stawel/magiczna-palka/mgr/praca/2d.png

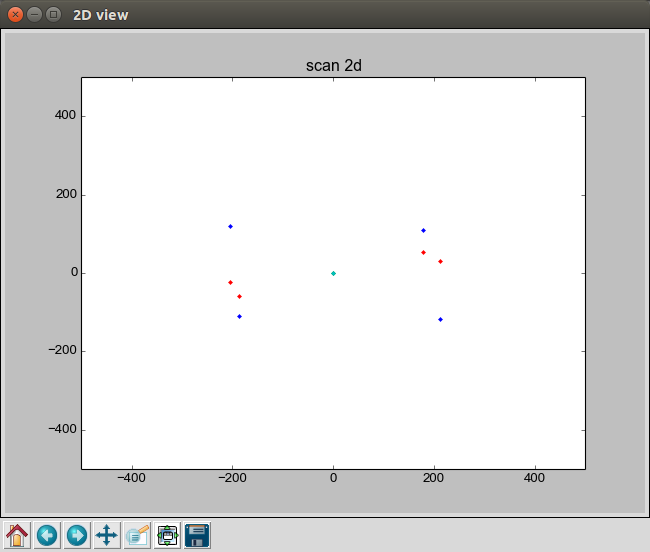
mgr/praca/2d.png
