stawel/magiczna-palka/mgr/praca/3d.png

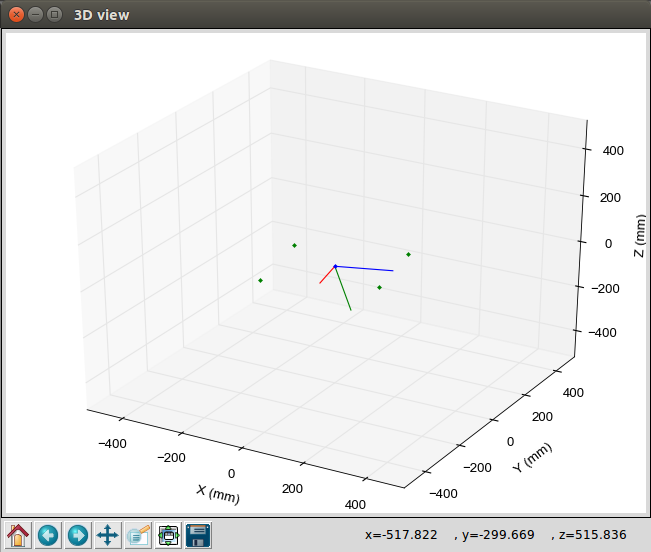
mgr/praca/3d.png
