stawel/magiczna-palka/mgr/praca/odbiornik_szkic.png

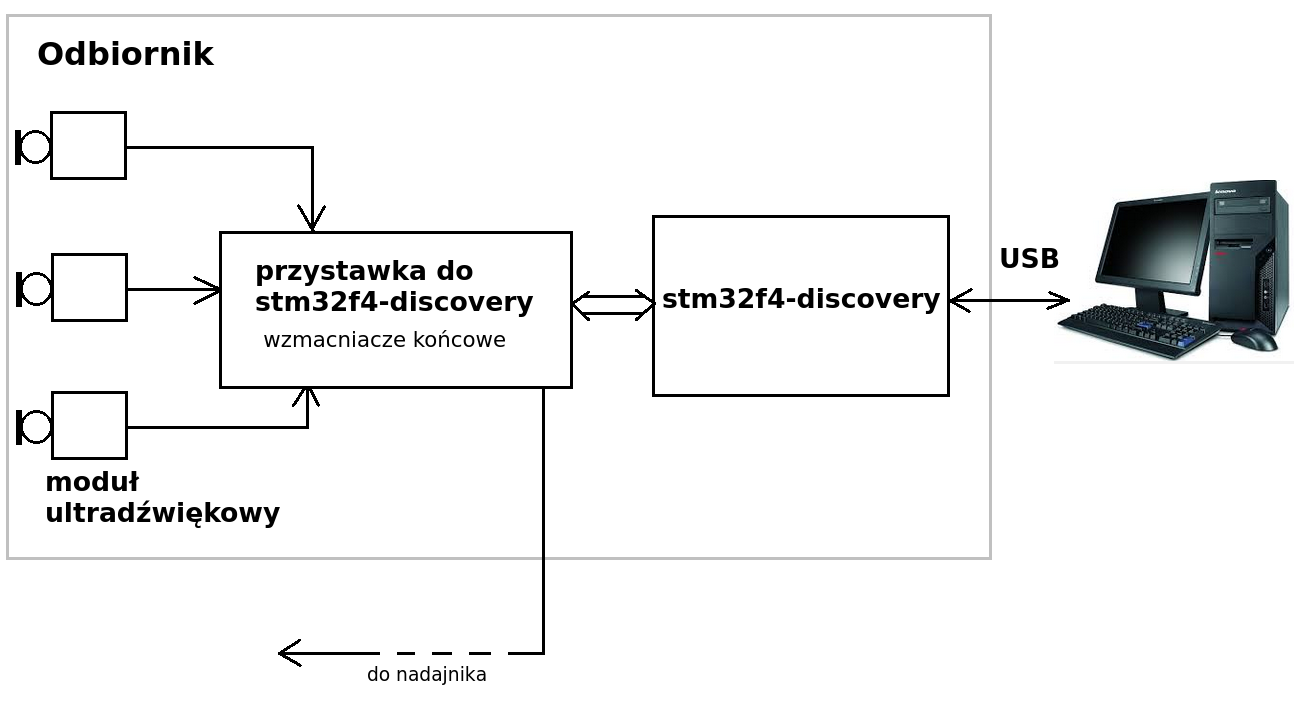
mgr/praca/odbiornik_szkic.png
