stawel/magiczna-palka/mgr/praca/polozenie.png

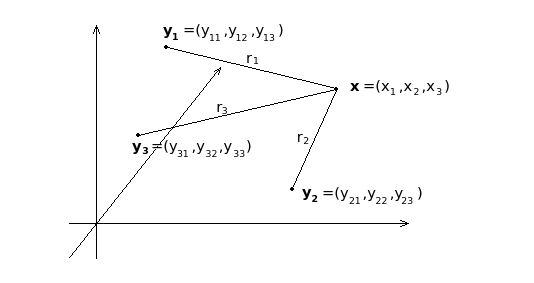
mgr/praca/polozenie.png
