stawel/magiczna-palka/mgr/praca/pomiar_odleglosci.png

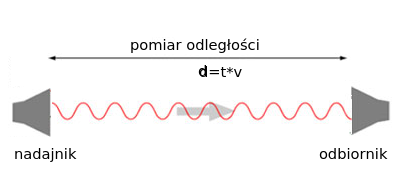
mgr/praca/pomiar_odleglosci.png
