stawel/magiczna-palka/mgr/praca/power.png

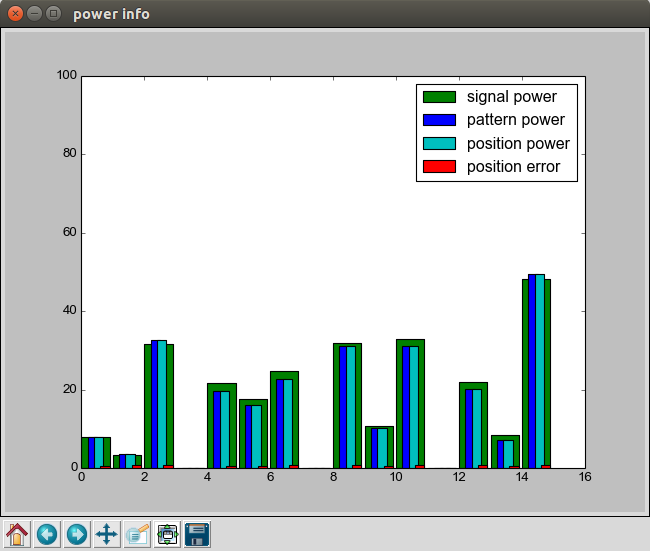
mgr/praca/power.png
