stawel/magiczna-palka/mgr/cad/nadajnik_H2.dxf

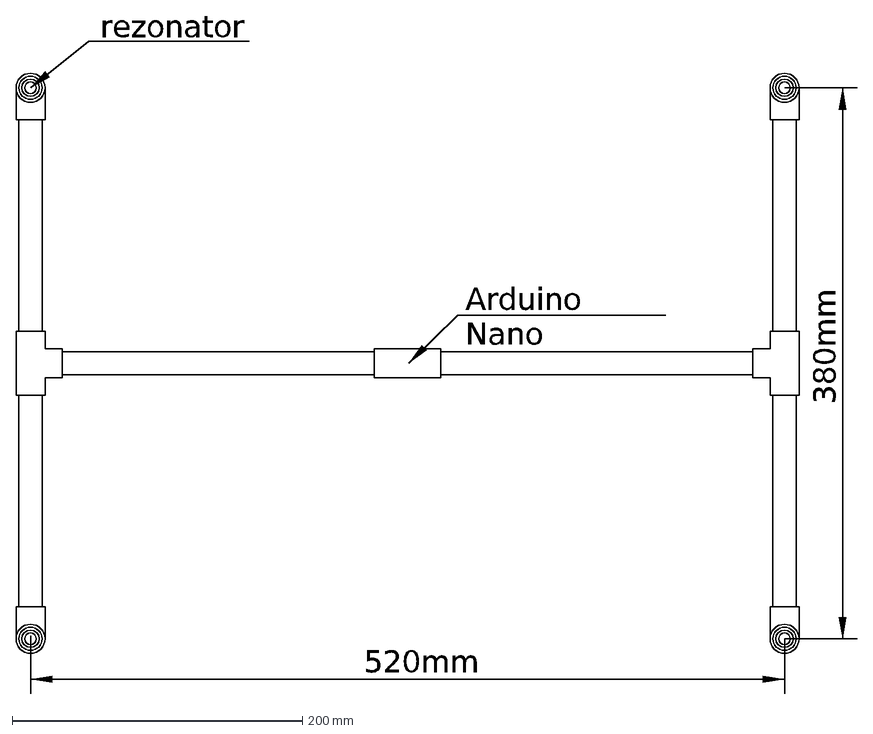
[picture p8: CAD file, 2015-10-09]
mgr/cad/nadajnik_H2.dxf
rezonator
Arduino Nano
520mm
380mm
