stawel/magiczna-palka/mgr/cad/trojkat.dxf

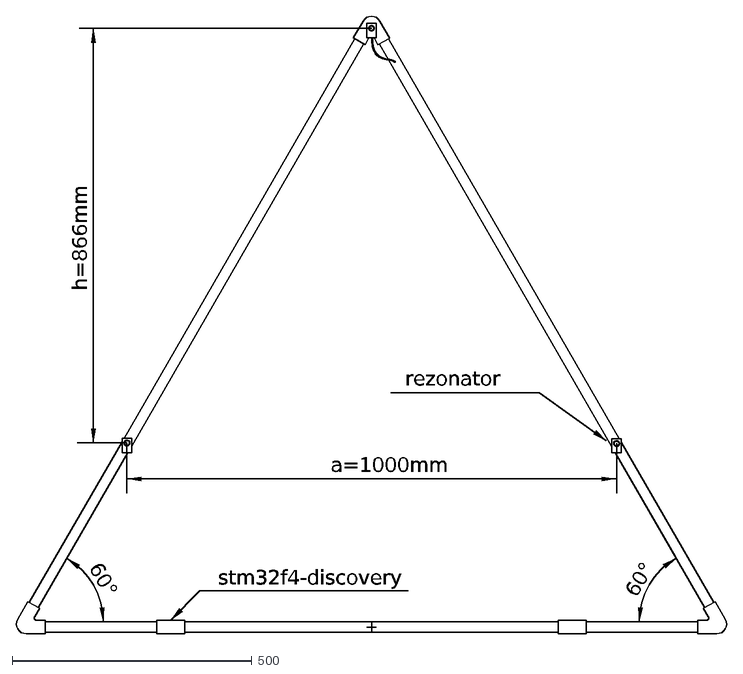
[picture p9: CAD file, 2015-10-09]
mgr/cad/trojkat.dxf
60°
stm32f4-discovery
h=866mm
a=1000mm
rezonator
