stawel/magiczna-palka/mgr/cad/nadajnik_H.dxf

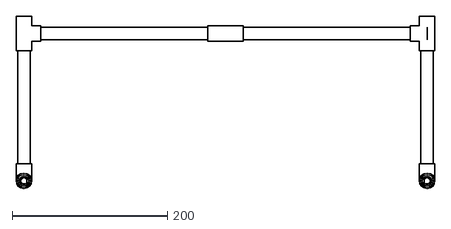
[picture p10: CAD file, 2014-08-22]
mgr/cad/nadajnik_H.dxf
540.0 x 222.0
