stawel/magiczna-palka/mgr/praca/kalibracja.tex

\chapter{Kalibracja}\label{r:kalibracja}

Do poprawnego działania prototupu niezbędne są wzorce
