stawel/magiczna-palka/mgr/praca/TODO.png

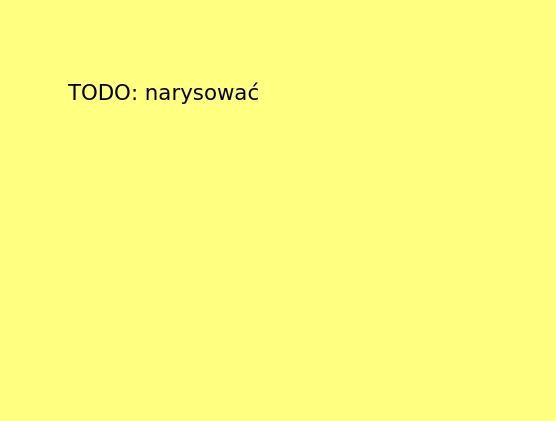
mgr/praca/TODO.png
