stawel/magiczna-palka/mgr/praca/transmitter.pdf

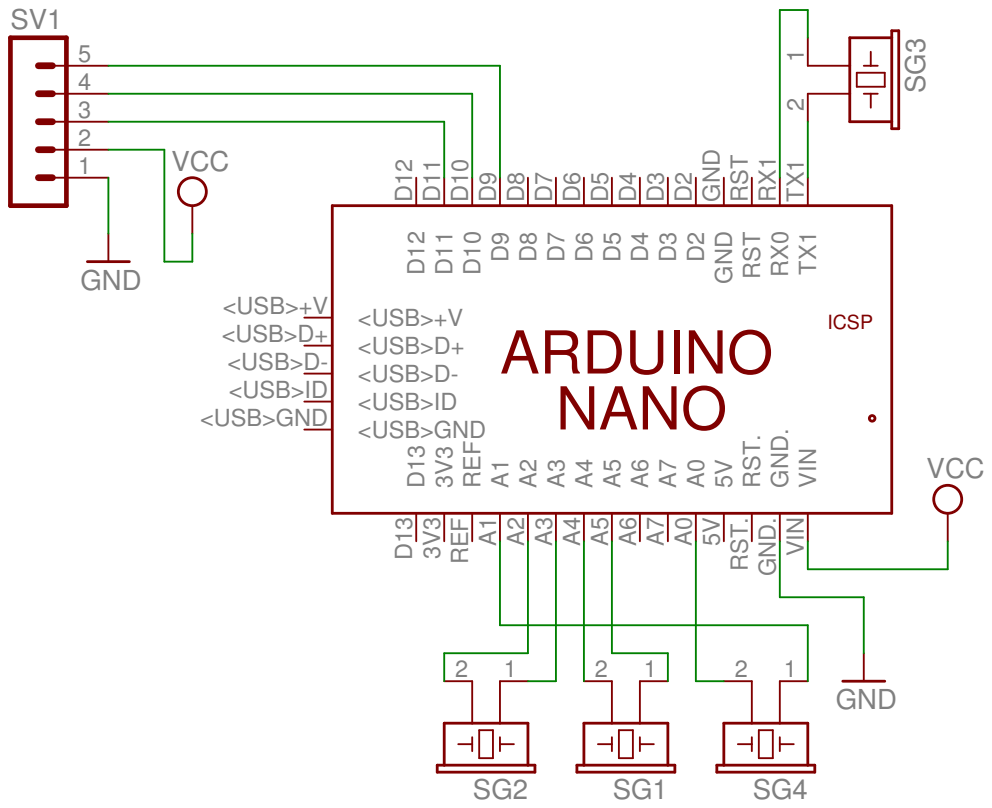
[picture p12: page 1]

5V RST. RST. GND. GND.
