stawel/magiczna-palka/mgr/praca/kalibracja_12x.pdf

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

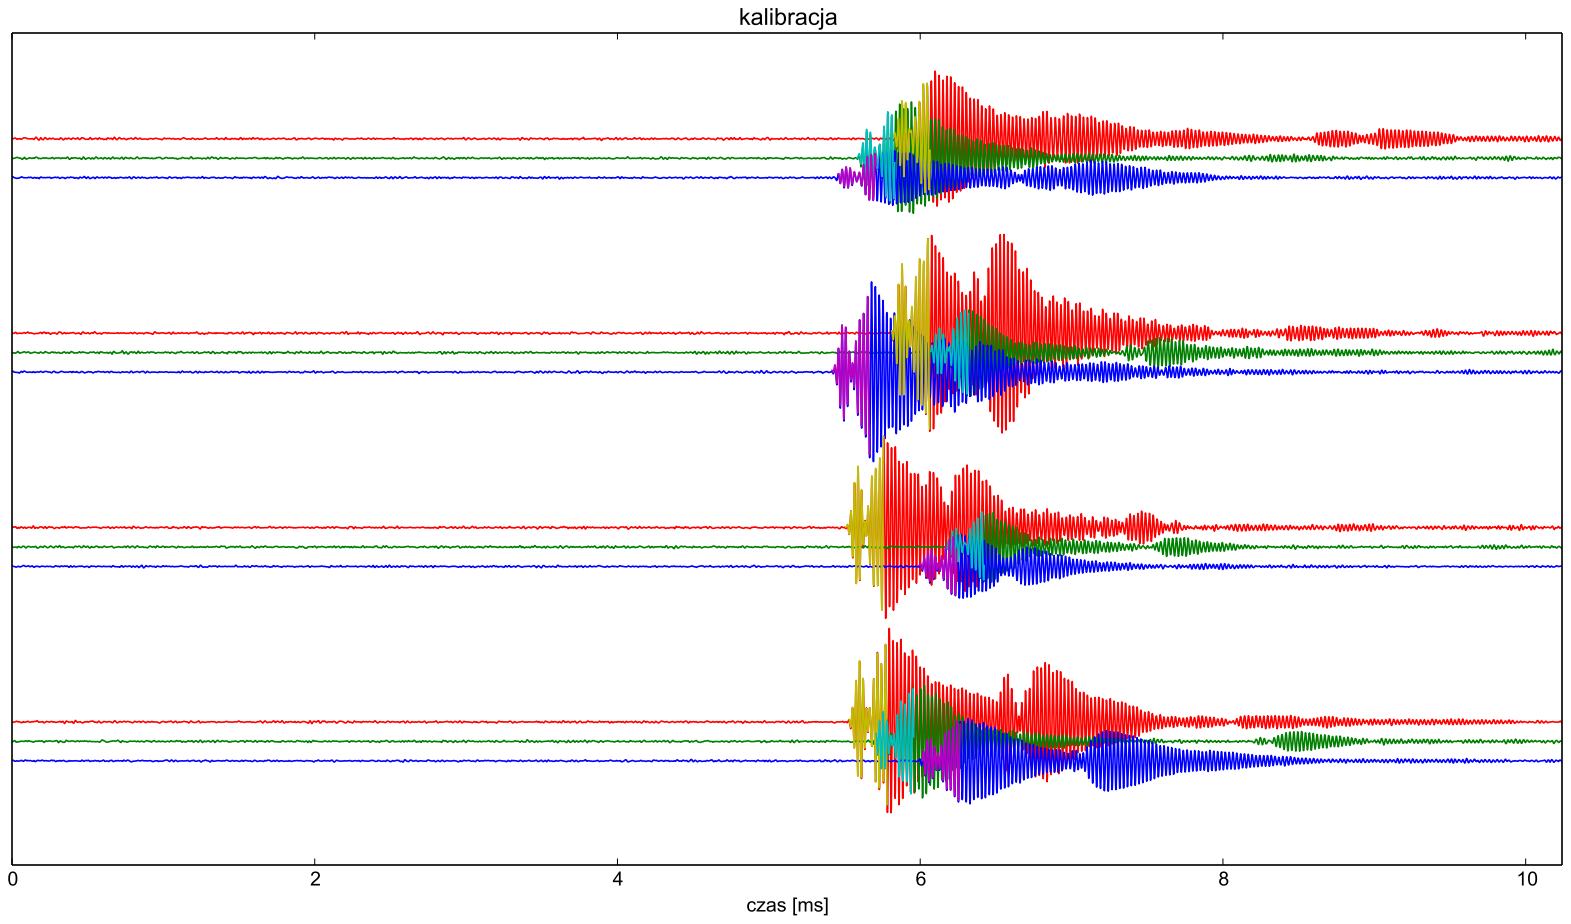
[picture p13: page 1]
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
