stawel/magiczna-palka/mgr/praca/nadajnik_H.pdf

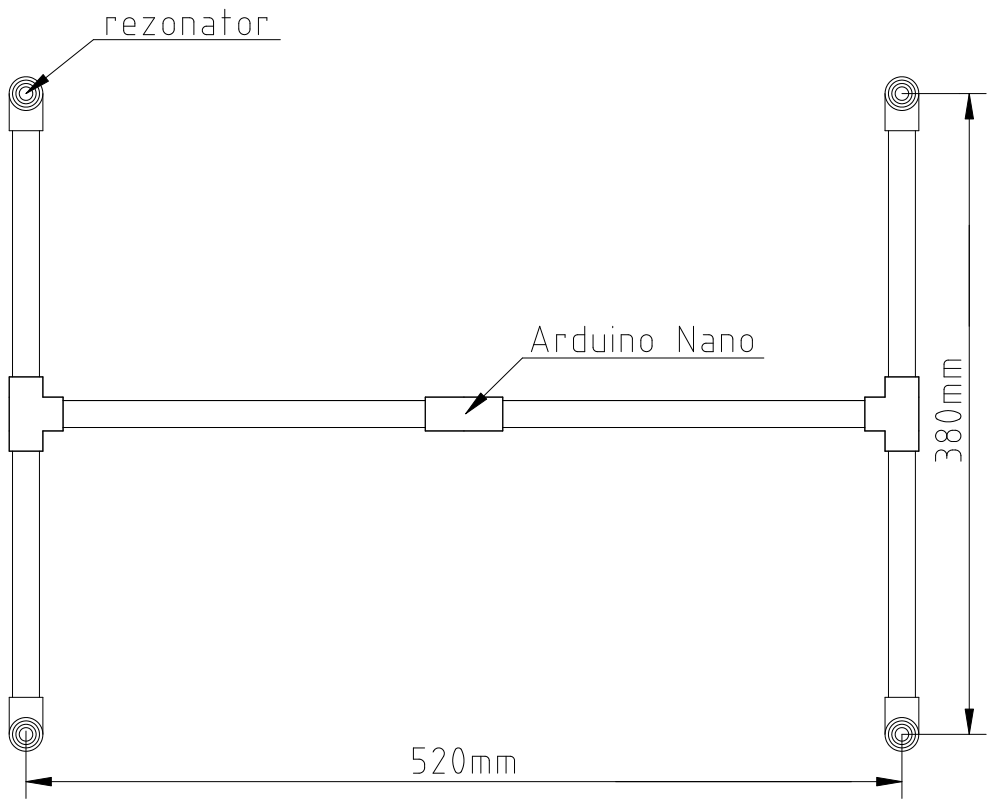
[picture p18: page 1]
