stawel/magiczna-palka/mgr/praca/trojkat.pdf

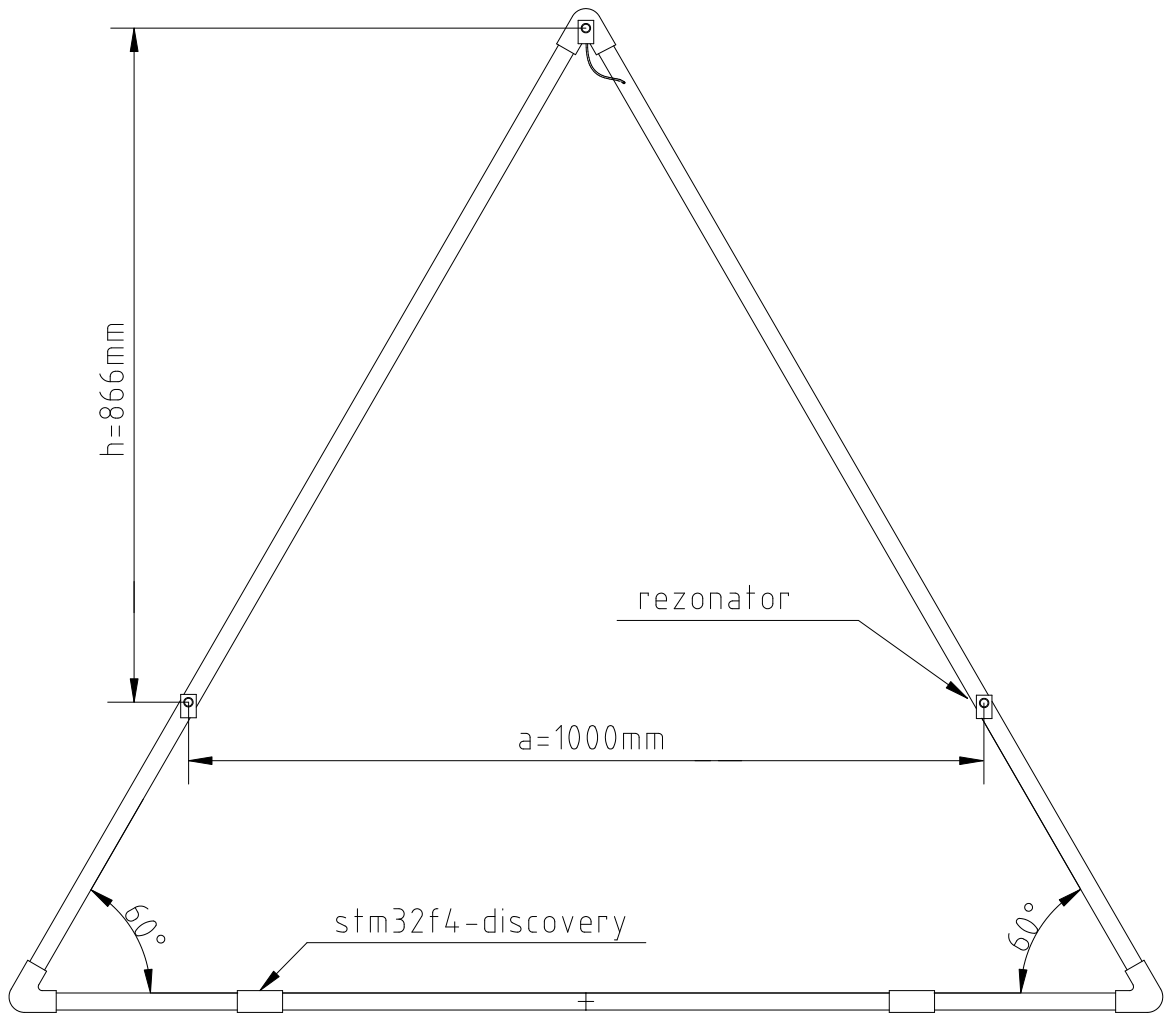
[picture p19: page 1]
