stawel/magiczna-palka/mgr/praca/mainboard2.pdf

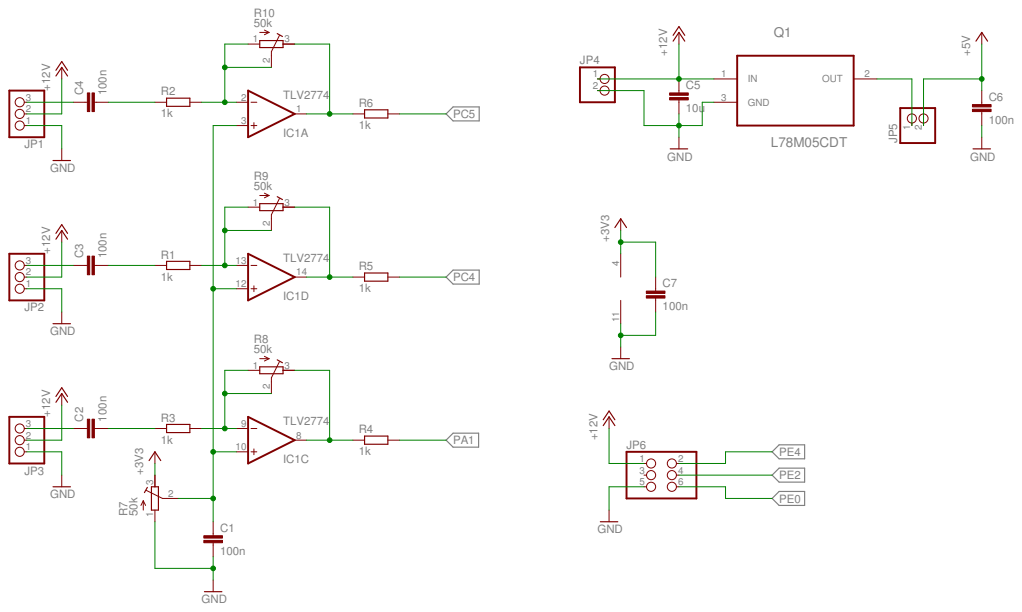
[picture p21: page 1]
