stawel/magiczna-palka/mgr/praca/receiver.pdf

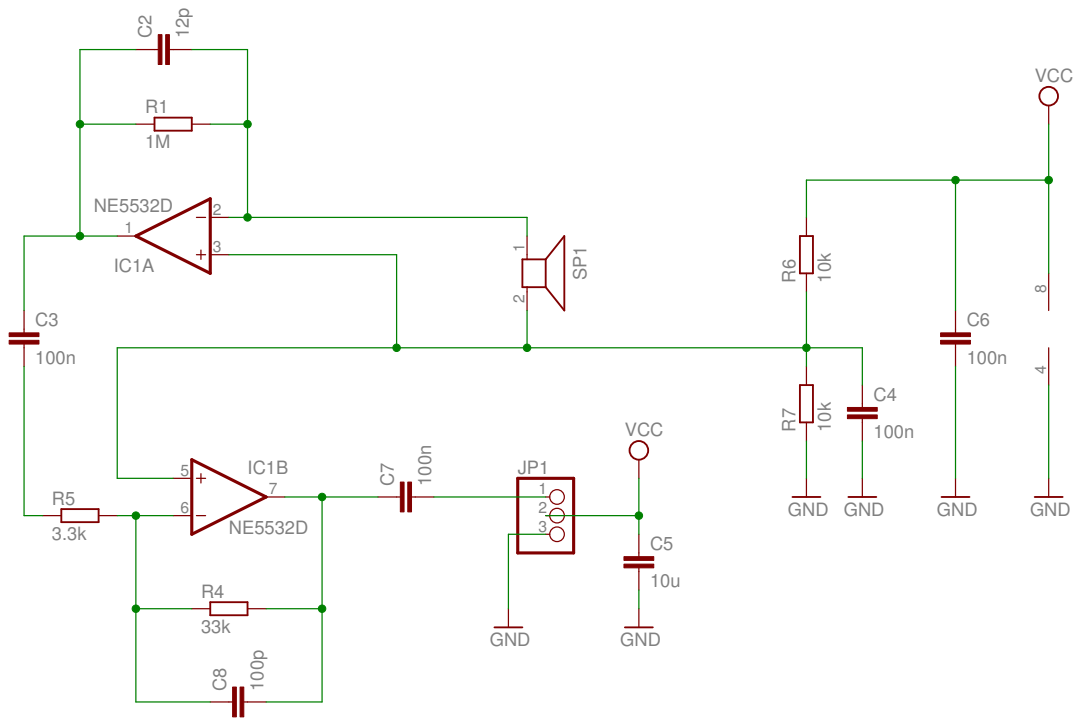
[picture p22: page 1]
