stawel/magiczna-palka/pos-receiver-sch/receiver/receiver.pdf

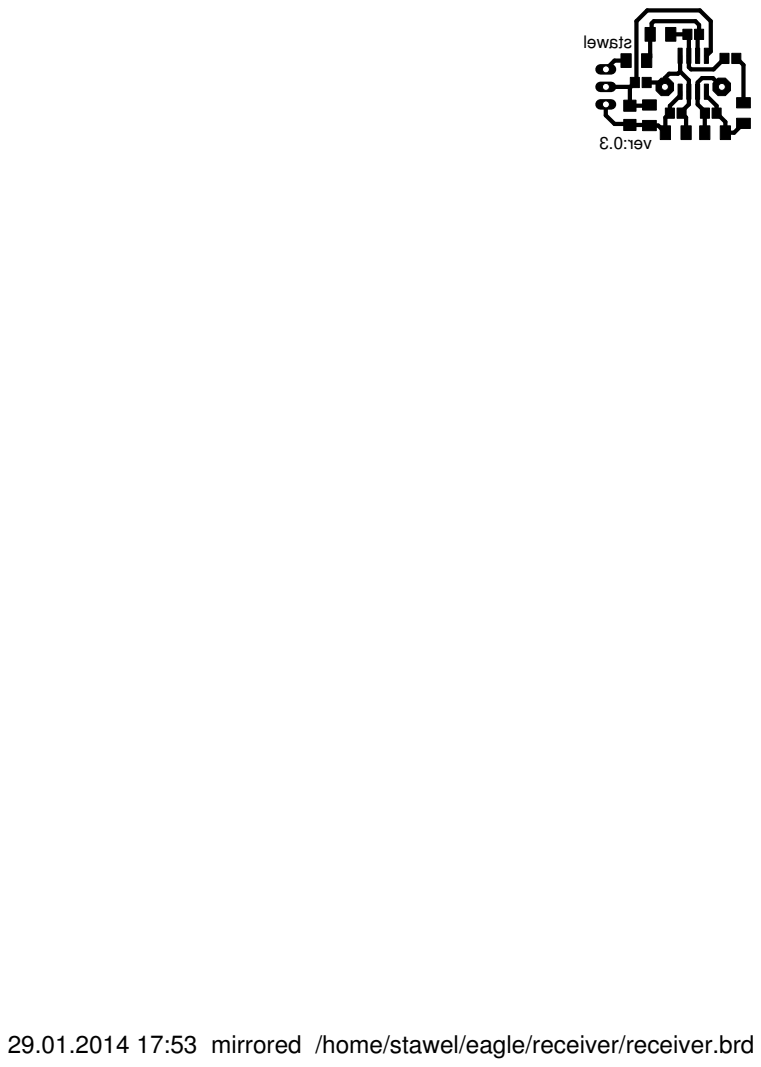
[picture p23: page 1]

29.01.2014 17:53 mirrored /home/stawel/eagle/receiver/receiver.brd
