stawel/magiczna-palka/pos-receiver-sch/mainboard/mainboard.pdf

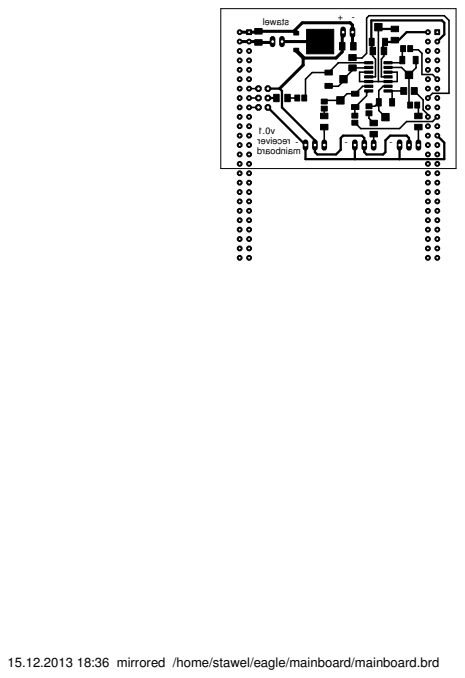
[picture p24: page 1]

r evi ecer dr aobni a m

15.12.2013 18:36 mirrored /home/stawel/eagle/mainboard/mainboard.brd
