stawel/magiczna-palka/pos-receiver-sch/receiver/receiver.brd

## EAGLE design pos-receiver-sch/receiver/receiver.brd (2014-02-06)

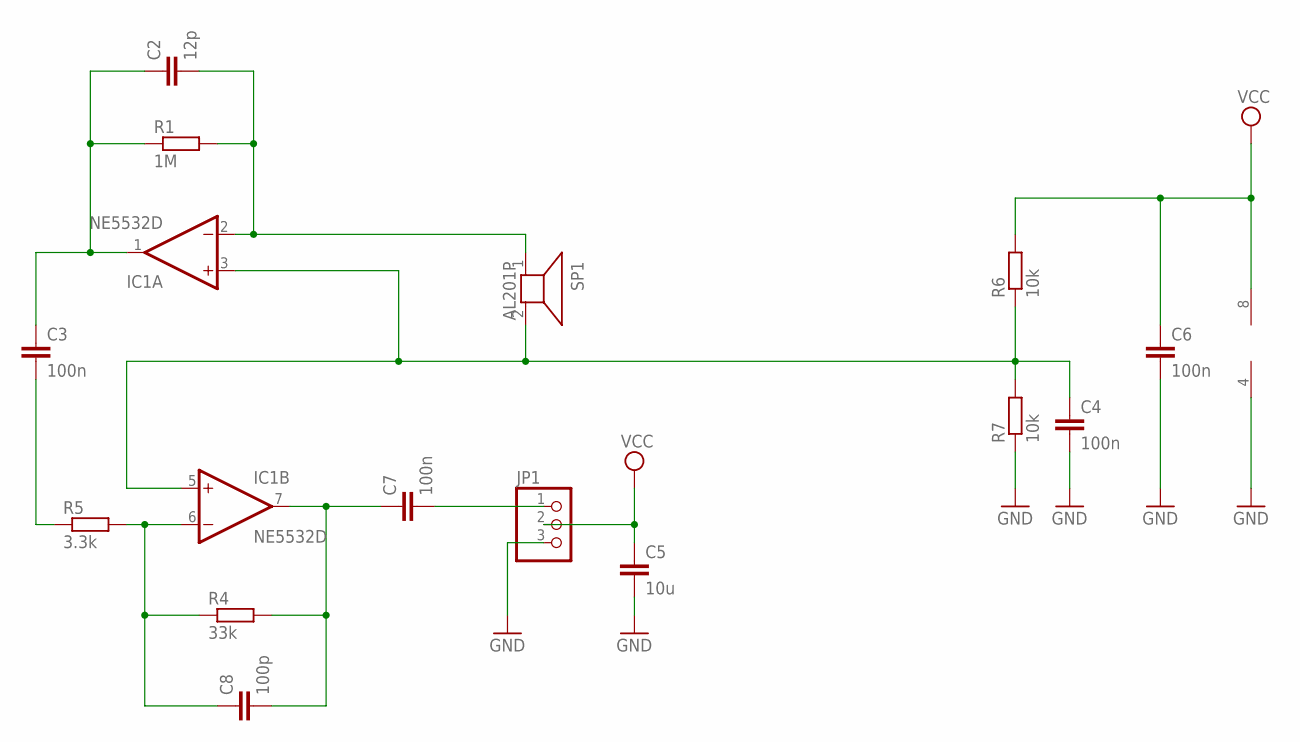
[picture p25: schematic receiver.sch]

Parts:
C2: 12p; C0805
C3, C4: 100n; C0805
C5: 10u; C0805
C6: 100n; C1206
C7: 100n; C1206K
C8: 100p; C0805
IC1: NE5532D; SO08
JP1: PINHD-1X3; 1X03
R1: 1M; R0805
R4: 33k; R0805
R5: 3.3k; R0805
R6, R7: 10k; R0805
SP1: AL201P

Connections:
GND: C4.2, C5.2, C6.2, IC1.4 (V-), JP1.3, R7.1
unnamed: C7.2, JP1.1
unnamed: C2.2, IC1.2 (-IN), R1.2, SP1.1
unnamed: C8.1, IC1.6 (-IN), R4.1, R5.2
unnamed: C7.1, C8.2, IC1.7 (OUT), R4.2
unnamed: C3.2, R5.1
unnamed: C2.1, C3.1, IC1.1 (OUT), R1.1
unnamed: C4.1, IC1.3 (+IN), IC1.5 (+IN), R6.1, R7.2, SP1.2
VCC: C5.1, C6.1, IC1.8 (V+), JP1.2, R6.2

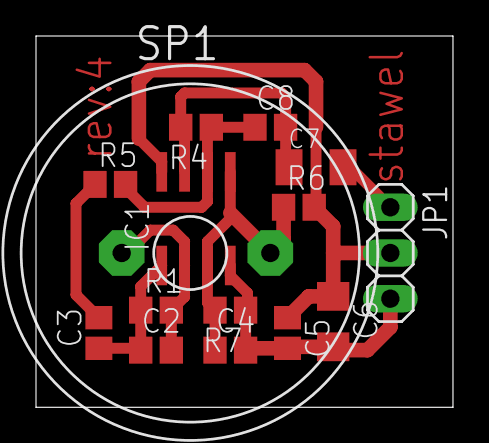
[picture p26: board receiver.brd from above]

Board: 2 copper layers, 23.2 x 20.6 mm, 15 parts (0 on the bottom side), 9 nets.
