stawel/magiczna-palka/pos-receiver-sch/mainboard/mainboard.brd

## EAGLE design pos-receiver-sch/mainboard/mainboard.brd (2013-12-15)

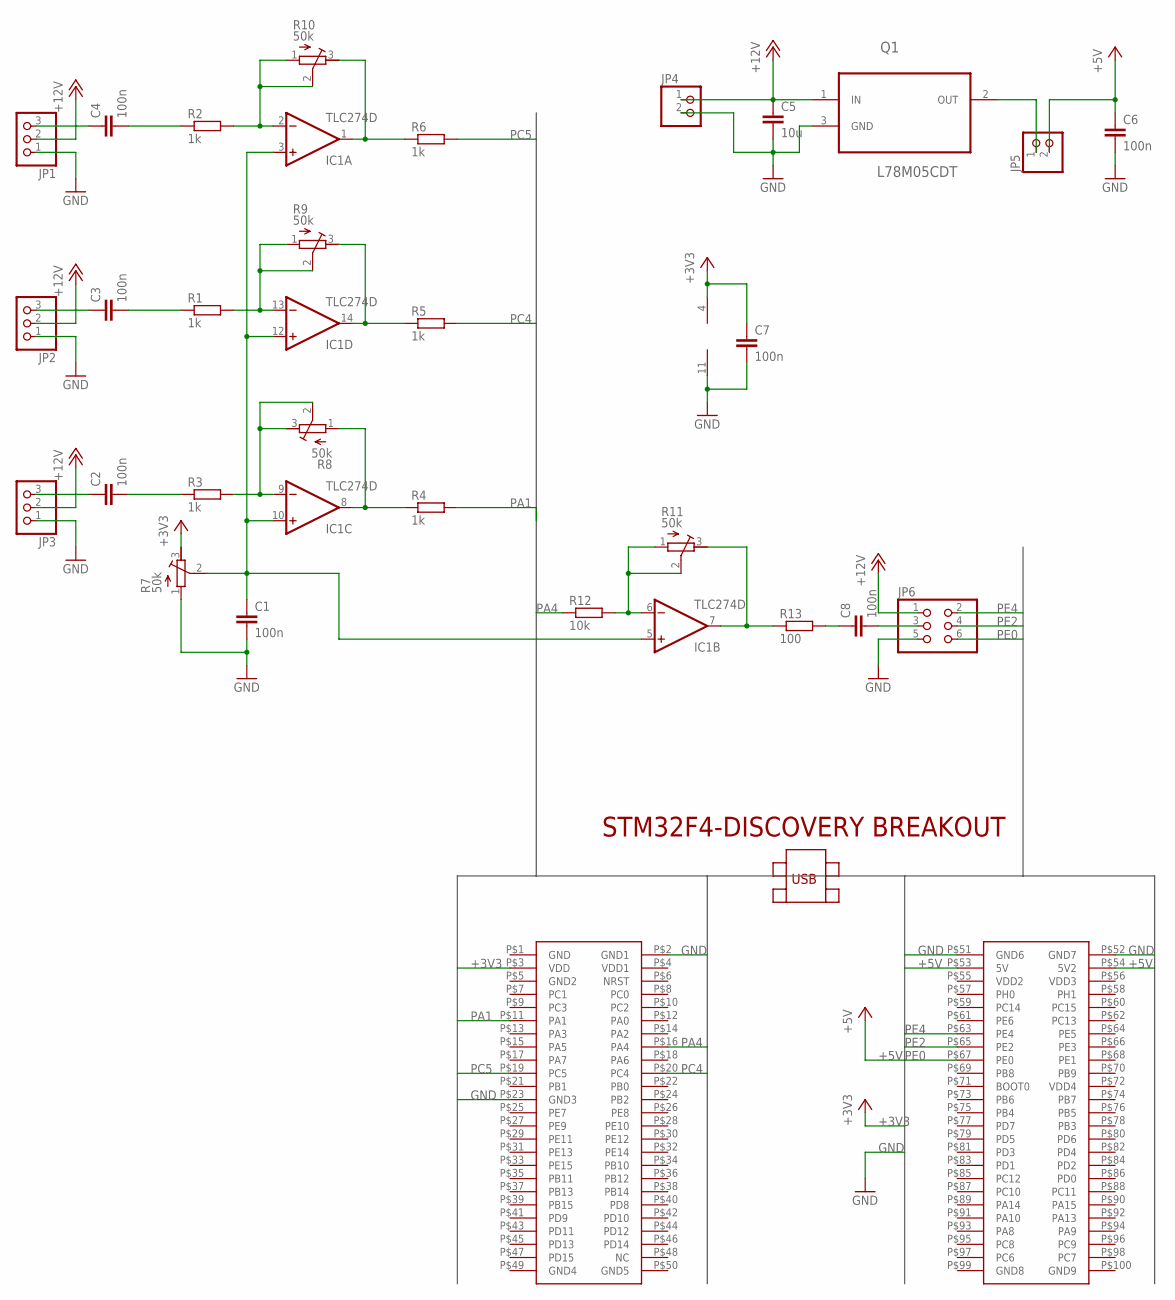
[picture p27: schematic mainboard.sch]

Parts:
C1, C2, C3, C4, C6, C7, C8: 100n; C1206K
C5: 10u; C1206K
IC1: TLC274D; SO14
JP1, JP2, JP3: PINHD-1X3; 1X03
JP4, JP5: PINHD-1X2; 1X02
JP6: PINHD-2X3; 2X03
Q1: L78M05CDT; TO225P972X240-3N
R1, R2, R3, R4, R6: 1k; M0805
R5: 1k; R1206
R7, R8, R9, R10, R11: 50k; RTRIM3314J
R12: 10k; M1206
R13: 100; M0805
U$1: STM32F4-DISCOVERY

Connections:
+3V3: C7.1, IC1.4 (V+), R7.3 (A), U$1.P$3 (VDD)
+5V: C6.1, JP5.2, U$1.P$53 (5V), U$1.P$54 (5V2)
+12V: C5.1, JP1.2, JP2.2, JP3.2, JP4.1, JP6.1, Q1.1 (IN)
GND: C1.2, C5.2, C6.2, C7.2, IC1.11 (V-), JP1.1, JP2.1, JP3.1, JP4.2, JP6.5, Q1.3 (GND), R7.1 (E), U$1.P$2 (GND1), U$1.P$23 (GND3), U$1.P$51 (GND6), U$1.P$52 (GND7)
unnamed: JP5.1, Q1.2 (OUT)
unnamed: IC1.6 (-IN), R11.1 (E), R11.2 (S), R12.2
unnamed: IC1.13 (-IN), R1.2, R9.1 (E), R9.2 (S)
unnamed: IC1.1 (OUT), R6.1, R10.3 (A)
unnamed: IC1.8 (OUT), R4.1, R8.1 (E)
unnamed: C2.2, R3.1
unnamed: C2.1, JP3.3
unnamed: C3.1, JP2.3
unnamed: C4.1, JP1.3
unnamed: C4.2, R2.1
unnamed: IC1.7 (OUT), R11.3 (A), R13.1
unnamed: IC1.14 (OUT), R5.1, R9.3 (A)
unnamed: C3.2, R1.1
unnamed: C1.1, IC1.3 (+IN), IC1.5 (+IN), IC1.10 (+IN), IC1.12 (+IN), R7.2 (S)
unnamed: C8.2, JP6.3
unnamed: C8.1, R13.2
unnamed: IC1.2 (-IN), R2.2, R10.1 (E), R10.2 (S)
unnamed: IC1.9 (-IN), R3.2, R8.2 (S), R8.3 (A)
PA1: R4.2, U$1.P$11 (PA1)
PA4: R12.1, U$1.P$16 (PA4)
PC4: R5.2, U$1.P$20 (PC4)
PC5: R6.2, U$1.P$19 (PC5)
PE0: JP6.6, U$1.P$67 (PE0)
PE2: JP6.4, U$1.P$65 (PE2)
PE4: JP6.2, U$1.P$63 (PE4)

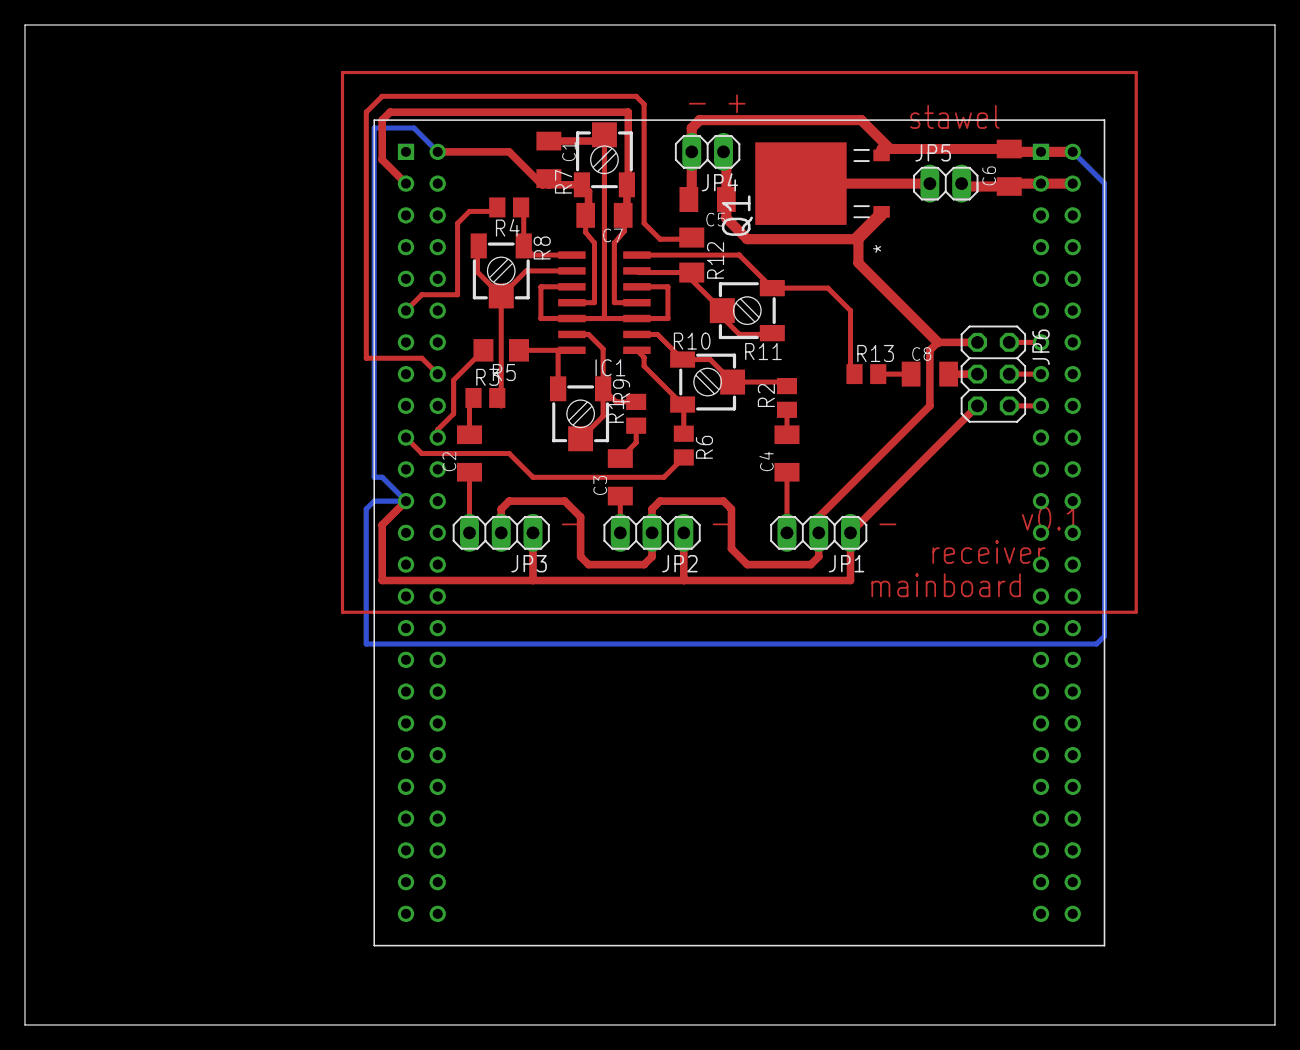
[picture p28: board mainboard.brd from above]

Board: 2 copper layers, 100.0 x 80.0 mm, 30 parts (0 on the bottom side), 29 nets.
