stawel/magiczna-palka/tools/oddane/odbiornik/adc.c

#include <usbd_callbacks.h>
#include <usb_endianness.h>
#include <usbd_api.h>
#include <stm32.h>
#include <inttypes.h>
#include <stm32f4xx_adc.h>
#include <stm32f4xx.h>
#include <stm32f4xx_dma.h>
#include <stm32f4xx_gpio.h>
#include <stm32f4xx_rcc.h>
#include <misc.h>
#include <delay.h>

#define MAX 1024 * 16
#define MAX_SIGNALS 3 * 2

#define ADC3_DR_ADDRESS     ((uint32_t)0x4001224C)
#define ADC_CDR_ADDRESS     ((uint32_t)0x40012308)

__IO uint8_t buf[MAX][MAX_SIGNALS];

#define PIN2 GPIO_Pin_2
#define PIN1 GPIO_Pin_4
#define PIN0 GPIO_Pin_5
#define PIN_GROUP GPIOE

void PIN_Configuration(void)
{
  /* Enable ADC3, DMA2 and GPIO clocks ****************************************/
    RCC_AHB1PeriphClockCmd(RCC_AHB1Periph_DMA2 | RCC_AHB1Periph_GPIOA | RCC_AHB1Periph_GPIOC | RCC_AHB1Periph_GPIOD |RCC_AHB1Periph_GPIOE, ENABLE);

    GPIO_InitTypeDef      GPIO_InitStructure;
    GPIO_InitTypeDef      GPIO_InitStructure_ADC;

    GPIO_InitStructure.GPIO_Pin = PIN0 | PIN1 | PIN2;
    GPIO_InitStructure.GPIO_Mode = GPIO_Mode_OUT;
    GPIO_InitStructure.GPIO_Speed = GPIO_Speed_100MHz;
    GPIO_InitStructure.GPIO_OType = GPIO_OType_OD;
    GPIO_InitStructure.GPIO_PuPd = GPIO_PuPd_NOPULL;
    GPIO_Init(PIN_GROUP, &GPIO_InitStructure);

    GPIO_SetBits(PIN_GROUP, PIN0 | PIN1 | PIN2);


    /* Configure ADC pins as analog input ******************************/
    GPIO_InitStructure_ADC.GPIO_Mode = GPIO_Mode_AN;
    GPIO_InitStructure_ADC.GPIO_PuPd = GPIO_PuPd_NOPULL;

    /* Configure ADC1,2 Channel 14 (pin 4), 15 (pin 5) as analog input ******************************/
    GPIO_InitStructure_ADC.GPIO_Pin = GPIO_Pin_4 | GPIO_Pin_5;
    GPIO_Init(GPIOC, &GPIO_InitStructure_ADC);

    /* Configure ADC3 Channel1 (pin 1) as analog input ******************************/
    GPIO_InitStructure_ADC.GPIO_Pin = GPIO_Pin_1;
    GPIO_Init(GPIOA, &GPIO_InitStructure_ADC);

}

void DMA_Config()
{
    DMA_InitTypeDef       DMA_InitStructure;

    /* DMA2 Stream0 channel0 configuration **************************************/
    DMA_InitStructure.DMA_Channel = DMA_Channel_0;
    DMA_InitStructure.DMA_PeripheralBaseAddr = (uint32_t)ADC_CDR_ADDRESS;
    DMA_InitStructure.DMA_Memory0BaseAddr = (uint32_t)&buf[0][0];
    DMA_InitStructure.DMA_DIR = DMA_DIR_PeripheralToMemory;
    DMA_InitStructure.DMA_BufferSize = MAX * MAX_SIGNALS;
    DMA_InitStructure.DMA_PeripheralInc = DMA_PeripheralInc_Disable;
    DMA_InitStructure.DMA_MemoryInc = DMA_MemoryInc_Enable;
//    DMA_InitStructure.DMA_PeripheralDataSize = DMA_PeripheralDataSize_HalfWord;
//    DMA_InitStructure.DMA_MemoryDataSize = DMA_MemoryDataSize_HalfWord;
    DMA_InitStructure.DMA_MemoryDataSize = DMA_MemoryDataSize_Byte;
    DMA_InitStructure.DMA_PeripheralDataSize = DMA_PeripheralDataSize_Byte;
//    DMA_InitStructure.DMA_Mode = DMA_Mode_Circular;
    DMA_InitStructure.DMA_Mode = DMA_Mode_Normal;
    DMA_InitStructure.DMA_Priority = DMA_Priority_High;
//    DMA_InitStructure.DMA_FIFOMode = DMA_FIFOMode_Disable;
    DMA_InitStructure.DMA_FIFOMode = DMA_FIFOMode_Enable;
    DMA_InitStructure.DMA_FIFOThreshold = DMA_FIFOThreshold_HalfFull;
    DMA_InitStructure.DMA_MemoryBurst = DMA_MemoryBurst_Single;
    DMA_InitStructure.DMA_PeripheralBurst = DMA_PeripheralBurst_Single;
    DMA_Init(DMA2_Stream0, &DMA_InitStructure);

    // Enable DMA1 Channel Transfer Complete interrupt
    DMA_ITConfig(DMA2_Stream0, DMA_IT_TC, ENABLE);

    NVIC_InitTypeDef NVIC_InitStructure;
    //Enable DMA1 channel IRQ Channel */
    NVIC_InitStructure.NVIC_IRQChannel = DMA2_Stream0_IRQn;
    NVIC_InitStructure.NVIC_IRQChannelPreemptionPriority = 0;
    NVIC_InitStructure.NVIC_IRQChannelSubPriority = 0;
    NVIC_InitStructure.NVIC_IRQChannelCmd = ENABLE;
    NVIC_Init(&NVIC_InitStructure);

    DMA_Cmd(DMA2_Stream0, ENABLE);

}

void ADC_Configuration(int pin)
{

    ADC_InitTypeDef       ADC_InitStructure;
    ADC_CommonInitTypeDef ADC_CommonInitStructure;

    RCC_APB2PeriphClockCmd(RCC_APB2Periph_ADC1 | RCC_APB2Periph_ADC2 | RCC_APB2Periph_ADC3, ENABLE);

    DMA_Config();

    /* ADC Common Init **********************************************************/
//    ADC_CommonInitStructure.ADC_Mode = ADC_Mode_Independent;
    ADC_CommonInitStructure.ADC_Mode = ADC_TripleMode_RegSimult;
    ADC_CommonInitStructure.ADC_Prescaler = ADC_Prescaler_Div2;
//    ADC_CommonInitStructure.ADC_DMAAccessMode = ADC_DMAAccessMode_Disabled;
    ADC_CommonInitStructure.ADC_DMAAccessMode = ADC_DMAAccessMode_1;
    ADC_CommonInitStructure.ADC_TwoSamplingDelay = ADC_TwoSamplingDelay_5Cycles;
    ADC_CommonInit(&ADC_CommonInitStructure);

    /* ADC3 Init ****************************************************************/
//    ADC_InitStructure.ADC_Resolution = ADC_Resolution_12b;
    ADC_InitStructure.ADC_Resolution = ADC_Resolution_8b;
    ADC_InitStructure.ADC_ScanConvMode = DISABLE;
    ADC_InitStructure.ADC_ContinuousConvMode = ENABLE;
    ADC_InitStructure.ADC_ExternalTrigConvEdge = ADC_ExternalTrigConvEdge_None;
    ADC_InitStructure.ADC_DataAlign = ADC_DataAlign_Right;
    ADC_InitStructure.ADC_NbrOfConversion = 1;
    ADC_Init(ADC3, &ADC_InitStructure);
    ADC_Init(ADC2, &ADC_InitStructure);
    ADC_Init(ADC1, &ADC_InitStructure);

    /* ADC3 regular channel12 configuration *************************************/
    ADC_RegularChannelConfig(ADC3, ADC_Channel_1,  1, ADC_SampleTime_3Cycles);
    ADC_RegularChannelConfig(ADC2, ADC_Channel_15, 1, ADC_SampleTime_3Cycles);
    ADC_RegularChannelConfig(ADC1, ADC_Channel_14, 1, ADC_SampleTime_3Cycles);

    /* Enable DMA request after last transfer (Single-ADC mode) */
//    ADC_DMARequestAfterLastTransferCmd(ADC3, ENABLE);

    /* Enable DMA request after last transfer (Multi-ADC mode)  */
    ADC_MultiModeDMARequestAfterLastTransferCmd(ENABLE);


    /* Enable ADC 1-3 */
    ADC_Cmd(ADC1, ENABLE);
    ADC_Cmd(ADC2, ENABLE);
    ADC_Cmd(ADC3, ENABLE);

    /* Enable ADC1 DMA - master*/
    ADC_DMACmd(ADC1, ENABLE);


    /* Start ADC3 Software Conversion */
    if(!(pin & 1)) GPIO_SetBits(PIN_GROUP,   PIN1);
    else           GPIO_ResetBits(PIN_GROUP, PIN1);
    if(!(pin & 2)) GPIO_SetBits(PIN_GROUP,   PIN2);
    else           GPIO_ResetBits(PIN_GROUP, PIN2);
    Delay(1000); //100us

    __disable_irq();
    GPIO_ResetBits(PIN_GROUP, PIN0);
    Delay(1000); //100us
    GPIO_SetBits(PIN_GROUP, PIN0);
    ADC_SoftwareStartConv(ADC1);
    __enable_irq();
}

void DMA2_Stream0_IRQHandler(void)
{
  //Test on DMA1 Channel1 Transfer Complete interrupt
  if(DMA_GetITStatus(DMA2_Stream0, DMA_IT_TCIF0))
  {
    DMA_ClearITPendingBit(DMA2_Stream0, DMA_FLAG_TCIF0);
    ADC_DMACmd(ADC1, DISABLE);

    /* Enable ADC3 */
    ADC_Cmd(ADC1, DISABLE);
    ADC_Cmd(ADC2, DISABLE);
    ADC_Cmd(ADC3, DISABLE);
    USBDwriteEx(ENDP1, (uint8_t const *)buf, MAX_SIGNALS*MAX);
  }
}

void adcStart(int c)
{
    ADC_Configuration(c);
}
