stawel/magiczna-palka/tools/scanner3d/27-error-refresh-power/test_get_pos.py

#!/usr/bin/python
from pylab import *
import serial
from numpy import *
import time
import matplotlib.pyplot as plt
import matplotlib.animation as animation
import mpl_toolkits.mplot3d.axes3d as p3
import math
import scipy.optimize as optimization
import scipy.signal as signal
import get_data
import get_dolek

print get_data.get_data(0)





fig1 = plt.figure()

plt.xlim(0, 4000)
plt.ylim(0, 256)
plt.title('test')

l1, = plt.plot([], [], 'r-')
l2, = plt.plot([], [], 'g-')
l3, = plt.plot([], [], 'b-')
l4, = plt.plot([], [], 'y-')
l5, = plt.plot([], [], 'c-')

lp1, = plt.plot([], [], 'r-')
lp2, = plt.plot([], [], 'g-')
lp3, = plt.plot([], [], 'b-')
lp4, = plt.plot([], [], 'y-')
lp5, = plt.plot([], [], 'c-')


szuk_org = [128.0, 128.0, 127.0, 128.0, 127.0, 127.0, 128.0, 127.0, 128.0, 127.0, 127.0, 127.0, 127.0, 128.0, 128.0, 128.0, 128.0, 128.0, 128.0, 128.0, 128.0, 129.0, 129.0, 129.0, 129.0, 129.0, 129.0, 129.0, 129.0, 129.0, 129.0, 128.0, 129.0, 128.0, 128.0, 128.0, 127.0, 127.0, 127.0, 126.0, 126.0, 126.0, 126.0, 126.0, 126.0, 126.0, 126.0, 126.0, 126.0, 126.0, 126.0, 127.0, 127.0, 128.0, 128.0, 129.0, 130.0, 130.0, 131.0, 131.0, 132.0, 132.0, 132.0, 132.0, 132.0, 133.0, 132.0, 132.0, 132.0, 131.0, 131.0, 130.0, 129.0, 128.0, 127.0, 126.0, 125.0, 124.0, 123.0, 122.0, 122.0, 121.0, 121.0, 120.0, 120.0, 121.0, 121.0, 122.0, 123.0, 124.0, 125.0, 126.0, 127.0, 129.0, 130.0, 132.0, 133.0, 135.0, 136.0, 137.0, 138.0, 138.0, 139.0, 139.0, 139.0, 138.0, 138.0, 137.0, 136.0, 134.0, 132.0, 130.0, 128.0, 126.0, 124.0, 123.0, 120.0, 119.0, 117.0, 116.0, 114.0, 114.0, 113.0, 113.0, 114.0, 114.0, 116.0, 117.0, 119.0, 121.0, 123.0, 125.0, 128.0, 131.0, 133.0, 136.0, 138.0, 140.0, 142.0, 144.0, 145.0, 146.0, 146.0, 146.0, 145.0, 145.0, 143.0, 141.0, 140.0, 137.0, 134.0, 132.0, 129.0, 125.0, 122.0, 120.0, 117.0, 115.0, 113.0, 111.0, 110.0, 109.0, 108.0, 108.0, 109.0, 110.0, 111.0, 113.0, 116.0, 118.0, 121.0, 124.0, 127.0, 130.0, 133.0, 136.0, 139.0, 142.0, 144.0, 146.0, 147.0, 148.0, 148.0, 149.0, 148.0, 148.0, 146.0, 144.0, 142.0, 139.0, 137.0, 134.0, 131.0, 127.0, 124.0, 121.0, 119.0, 116.0, 114.0, 111.0, 110.0, 109.0, 108.0, 108.0, 108.0, 109.0, 110.0, 111.0, 113.0, 115.0, 118.0, 121.0, 123.0, 126.0, 129.0, 132.0, 135.0, 138.0, 140.0, 142.0, 144.0, 145.0, 146.0, 147.0, 147.0, 147.0, 146.0, 145.0, 143.0, 142.0, 140.0, 137.0, 135.0, 132.0, 129.0, 127.0, 124.0, 121.0, 119.0, 117.0, 115.0, 113.0, 112.0, 111.0, 111.0, 111.0, 111.0, 112.0, 113.0, 114.0, 116.0, 118.0, 120.0, 122.0, 124.0, 127.0, 129.0, 132.0, 134.0, 136.0, 138.0, 139.0, 141.0, 141.0, 142.0, 143.0, 143.0, 142.0, 142.0, 141.0, 140.0, 138.0, 137.0, 135.0, 133.0, 131.0, 129.0, 127.0, 125.0, 123.0, 122.0, 120.0, 119.0, 118.0, 117.0, 117.0, 117.0, 117.0, 118.0, 118.0, 119.0, 120.0, 121.0, 123.0, 124.0, 125.0, 127.0, 128.0, 129.0, 131.0, 132.0, 133.0, 133.0, 134.0, 135.0, 135.0, 135.0, 135.0, 135.0, 134.0, 134.0, 133.0, 133.0, 132.0, 131.0, 130.0, 130.0, 129.0, 128.0, 128.0, 127.0, 127.0, 127.0, 127.0, 127.0, 127.0, 127.0, 127.0, 127.0, 127.0, 128.0, 128.0, 128.0, 128.0, 128.0, 128.0, 128.0, 128.0, 128.0, 127.0, 127.0, 126.0, 126.0, 125.0, 125.0, 124.0, 124.0, 124.0, 123.0, 123.0, 123.0, 123.0, 123.0, 124.0, 124.0, 125.0, 126.0, 126.0, 128.0, 128.0, 130.0, 131.0, 133.0, 134.0, 135.0, 136.0, 137.0, 138.0, 138.0, 139.0, 139.0, 139.0, 138.0, 138.0, 136.0, 136.0, 134.0, 133.0, 131.0, 129.0, 127.0, 125.0, 123.0, 121.0, 119.0, 117.0, 115.0, 113.0, 112.0, 112.0, 111.0, 111.0, 111.0, 112.0, 113.0, 114.0, 116.0, 118.0, 121.0, 123.0]
szuk = [[],[],[]]
szuk_avr = sum(szuk_org) / float(len(szuk_org))
for x in szuk_org:
    szuk[0].append(x-szuk_avr)
    szuk[1].append(x-szuk_avr)
    szuk[2].append(x-szuk_avr)

szukc = correlate(szuk[0],szuk[0])[0]
szuk_cor = [szukc,szukc,szukc]
print szuk_cor
#exit()

def refresh_szuk(s,idx):
    global szuk, szuk_cor
    sw_avr = sum(s) / float(len(s))
    sw = []
    for x in s:
        sw.append(x-sw_avr)
    sw_cor = correlate(sw,sw)[0]
    old_cor = correlate(sw,szuk[idx])[0]
    error = get_error(szuk[idx],sw,szuk_cor[idx],old_cor)[1]
    power = sqrt(sw_cor)
    print 'idx: %d  power: %10.3f nowa corelacja: %10.3f  cor old: %10.3f error: %3.10f' % (idx, power, sw_cor , old_cor , error)
    if(error<1. and power > 150.0):
        szuk_cor[idx]=sw_cor
        szuk[idx]=sw


def get_error(xl,yl,xx_cor,xy_cor):
    error_wsp=2.
    error=100
    suma=0
    cor=abs(xy_cor)/xx_cor
    if len(xl) == len(yl):
        for x,y in zip(xl,yl):
            suma+=((y-x*cor)/error_wsp)**2
        error=sqrt(suma/abs(xy_cor))
    return suma/10., error

def get_pos(y,idx):
    avr = sum(y) / float(len(y))
    cy = [x-avr for x in  y]
    data_s=correlate(cy ,szuk[idx])
    data_e = []
    data_c = []
    duze = signal.argrelmax(data_s)[0]
    for j in duze:
        v,e = get_error(szuk[idx],cy[j:j+len(szuk[idx])], szuk_cor[idx], data_s[j])
        data_c.append(v)
        data_e.append(e)
    if len(data_e) > 0:
        pos_i = argmin(data_e)
        pos = duze[pos_i]
    else:
        pos = 0

    return data_s,pos, data_s[pos], data_e 


def cut_arrays(x,y):
    m=min(len(x),len(y))
    return x[:m],y[:m]


def update_line(num):
    idx = 2
    x, y, cut_pos_min, cut_x, cut_y = get_dolek.get_data_gorka(idx, len(szuk[idx]));

    l1.set_data(x,y)
    y2,pos_fk_min, val_cor,y3 = get_pos(cut_y,idx)

    l2.set_data(cut_arrays(cut_x,[i/1000+195. for i in y2]))
    l5.set_data(cut_arrays(cut_x,[i+195. for i in y3]))

    pos_fk_min += cut_pos_min
    pos_fk_max =  pos_fk_min + len(szuk[idx])
    r,gamma,d = get_dolek.get_gamma(y[pos_fk_min:pos_fk_max],200.)
    pos = pos_fk_min-gamma

    pos = pos_fk_min-gamma
    print pos_fk_min, pos
#    print y[int(pos-100):int(pos)+len(szuk[idx])]
    refresh_szuk(y[int(math.floor(pos)):int(math.floor(pos))+len(szuk[idx])],idx)
    lp2.set_data([pos,pos],[0,256])
#    lp3.set_data([pos_fk_min,pos_fk_min],[0,256])
#    lp1.set_data([cut_pos_min,cut_pos_min],[0,256])
#    lp4.set_data([cut_pos_max,cut_pos_max],[0,256])

    cx= x[pos_fk_min:(pos_fk_min+len(szuk[idx]))]
    cy= y[pos_fk_min:(pos_fk_min+len(szuk[idx]))]
    avr_cy = sum(cy)/float(len(cy))
    l3.set_data(cut_arrays(cx,[i+195. for i in szuk[idx]]))
    l4.set_data(cut_arrays(cx,[abs(cy[i] -  szuk[idx][i]  * val_cor/szuk_cor[idx] - avr_cy) +avr_cy  for i in range(min(len(szuk[idx]),len(cy)))]))
    z = [ szuk[idx][i]  * val_cor/szuk_cor[idx] + avr_cy  for i in range(len(szuk[idx])
)]
    l3.set_data(cut_arrays(cx,z))
#    l3.set_data(x2,sy)



line_ani = animation.FuncAnimation(fig1, update_line, None,
    interval=30)
#, blit=True)
#line_ani.save('lines.mp4')


plt.show()
