stawel/magiczna-palka/tools/scanner3d/00-test-get-data/test_input_signal.py

#!/usr/bin/python
# -*- coding: utf-8 -*-
from __future__ import unicode_literals

from pylab import *
import serial
from numpy import *
import time
import matplotlib.pyplot as plt
import matplotlib.animation as animation
import mpl_toolkits.mplot3d.axes3d as p3
import math
import scipy.optimize as optimization
import scipy.signal as signal

import sys
sys.path.append('..')
import mp3d.signal
import mp3d.com


fft_size=2048*2*2
Fsampling_kHz = mp3d.com.Fsampling_kHz

#Tsampling_ms = 1.0 / Fsampling_kHz

fig1 = plt.figure()

#ax_data = plt.subplot(2,1,1)
plt.xlim(00/Fsampling_kHz, 300/Fsampling_kHz)
#plt.ylim(-228, 228)
plt.ylim(-10, 10)
plt.xlabel('czas [ms]')
plt.ylabel('napięcie [V]')

#plt.xlim(7700, 10000)
plt.title('sygnał wyjściowy')

l1, = plt.plot([], [], 'r-')
l2, = plt.plot([], [], 'k-')
l3, = plt.plot([], [], 'b-')
l4, = plt.plot([], [], 'y-')
l5, = plt.plot([], [], 'c-')

lp1, = plt.plot([], [], 'r-')
lp2, = plt.plot([], [], 'g-')
lp3, = plt.plot([], [], 'b-')
lp4, = plt.plot([], [], 'y-')
lp5, = plt.plot([], [], 'c-')



def arrow(x1, x2, text):
    height = 7
    offset = 0.001
    offseth = 0.1
    pylab = plt
    lwidth = 1
    offsetp = 0.3
    pylab.plot((x1, x2), (height, height), 'k', linewidth = lwidth)
    pylab.plot((x1, x1 + offset * 2), (height, height - offseth), 'k', linewidth = lwidth)
    pylab.plot((x1, x1 + offset * 2), (height, height + offseth), 'k', linewidth = lwidth)
    pylab.plot((x2, x2 - offset * 2), (height, height - offseth), 'k', linewidth = lwidth)
    pylab.plot((x2, x2 - offset * 2), (height, height + offseth), 'k', linewidth = lwidth)

    pylab.plot((x2, x2), (height+offsetp, height-offsetp), 'k:', linewidth = lwidth)
    pylab.plot((x1, x1), (height+offsetp, height-offsetp), 'k:', linewidth = lwidth)
    pylab.text((x1+x2)/2, height+offsetp, text, {'color' : 'k', 'fontsize' : 12},horizontalalignment='center')


plt.annotate('annotate', xy=(2, 1), xytext=(3, 4),
            arrowprops=dict(facecolor='black', shrink=0.05))


okres = 6.6289-6.60423

arrow(0, okres, "część wzbudzająca")
arrow(okres*1.5, okres*3, "część tłumiąca")

idx = 0

def update_line(num):
    global idx
    #mp3d.com.read_all_data()
    #y1, y2, y3 = mp3d.com.get(idx*3+0), mp3d.com.get(idx*3+1), mp3d.com.get(idx*3+2);
    y1 = arange(0,1000)
    x1 = arange(0,len(y1)) / Fsampling_kHz
    x2 = arange(0,len(y1)) / Fsampling_kHz
    x3 = arange(0,len(y1)) / Fsampling_kHz

#    l1.set_data(x1,y1+100)
    s = 0.0001
    signal = 5
    l2.set_data(
    [-10,0,    s ,okres/2, okres/2 + s, okres, okres+s, okres*3/2, okres*3/2+s, okres*2, okres*2+s, okres*5/2, okres*5/2+s, okres*3,okres*3+s, 100],
    [0  ,0,signal,signal , -signal,   -signal,       0,         0,      signal,  signal,   -signal,   -signal,      signal, signal ,0          ,0] )
#    l3.set_data(x3,y3-100)
    return


def onclick(event):
    global idx
    if event.key == 'n':
        idx=(idx+1+4)%4
    if event.key == 'p':
        idx=(idx-1+4)%4
    print idx



cid = fig1.canvas.mpl_connect('key_press_event', onclick)

line_ani = animation.FuncAnimation(fig1, update_line, None,
    interval=30)
#, blit=True)
#line_ani.save('lines.mp4')

try:
    plt.show()
finally:
    mp3d.com.exit()
