stawel/magiczna-palka/(commit log)

2013-12-01 DMA interrupt handler
2013-12-05 schematy do odbiornika
    [odbiornik.brd, odbiornik.sch, odbiornik2.brd, odbiornik2.sch]
2013-12-10 zmiany w schemacie
    [odbiornik.brd, odbiornik2.sch, receiver.brd, receiver.sch]
2013-12-10 receiver-sch ver: 0.2
    [receiver.brd, receiver.sch]
2014-01-06 com in separate thread
2014-01-06 exit com thread
2014-01-23 sign filter
2014-01-28 charge amp
    [receiver.brd, receiver.sch]
2015-10-09 trojkat ok
    [trojkat.dxf]
